awtismlover/Regin-Line-follower-v1/regin_line_follower/hardware/3d printed stuff/regin_sensor_mount v2.3mf

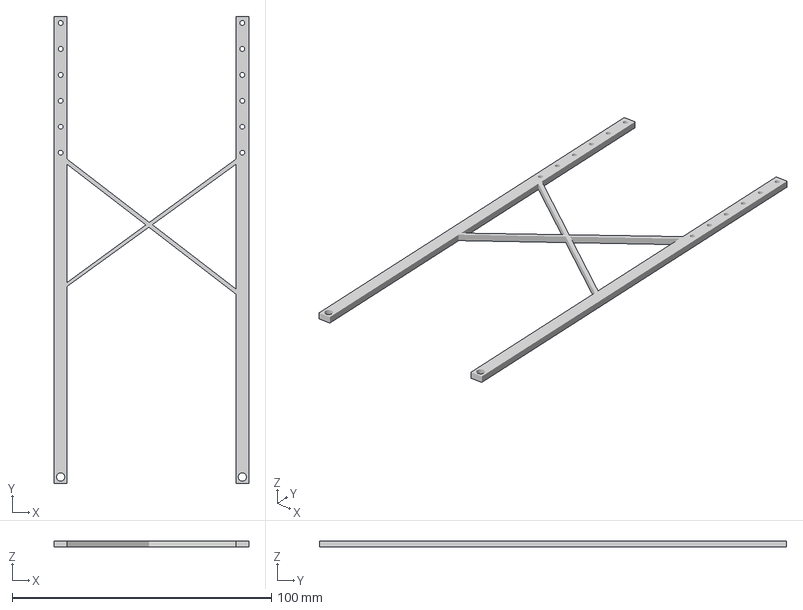
[picture p1: CAD file, 2024-11-30]
regin_line_follower/hardware/3d printed stuff/regin_sensor_mount v2.3mf
75.0 x 180.0 x 2.50 mm
