awtismlover/Regin-Line-follower-v1/regin_line_follower/hardware/PCB/3D_model/12sensor.step

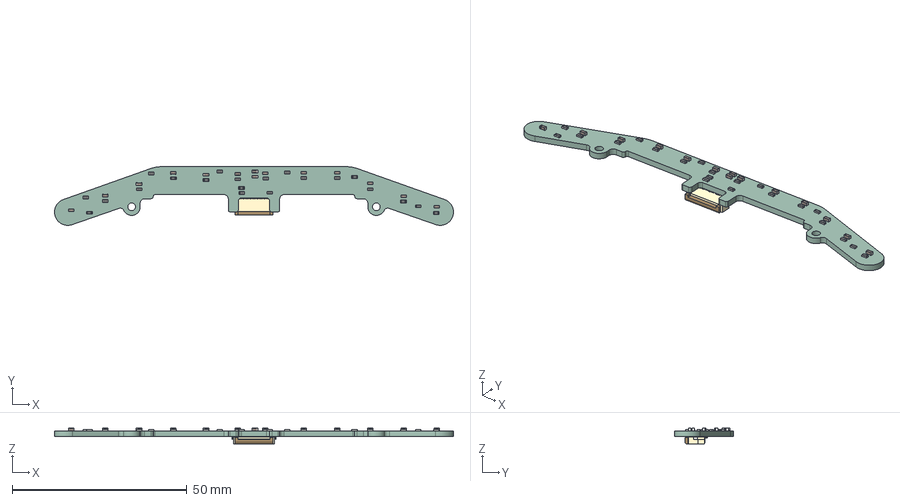
[picture p2: CAD file, 2024-11-30]
regin_line_follower/hardware/PCB/3D_model/12sensor.step
114.1 x 16.8 x 4.50 mm
C_0603_1608Metric x 14
R_0603_1608Metric x 21
Hirose_FH12_xxS_0_5SH_Parametric_v0_1
12sensor_PCB
