awtismlover/Regin-Line-follower-v1/regin_line_follower/hardware/PCB/main_board/hc-04/HC-04 v2.step

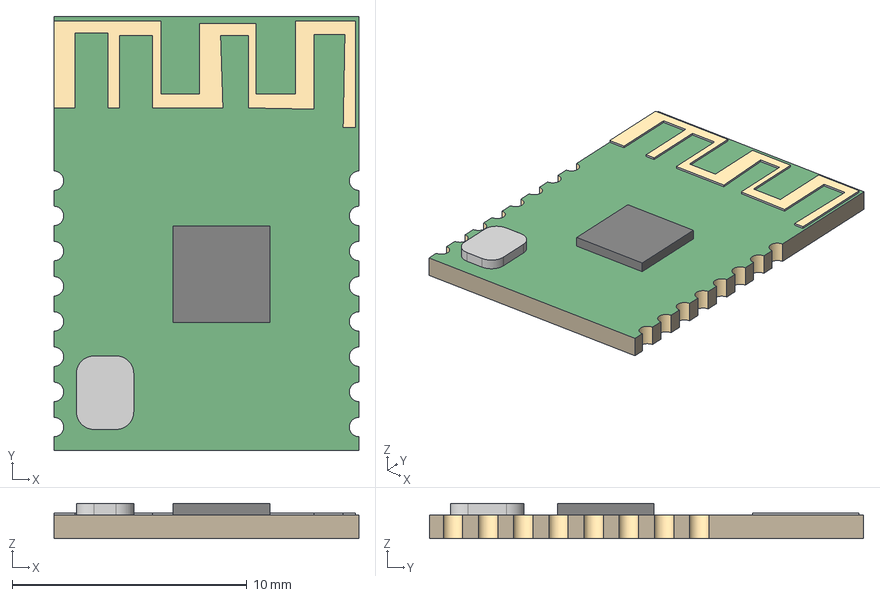
[picture p3: CAD file, 2024-11-30]
regin_line_follower/hardware/PCB/main_board/hc-04/HC-04 v2.step
13.0 x 18.5 x 1.50 mm
