awtismlover/Regin-Line-follower-v1/regin_line_follower/hardware/3d printed stuff/linefollower clip v2.3mf

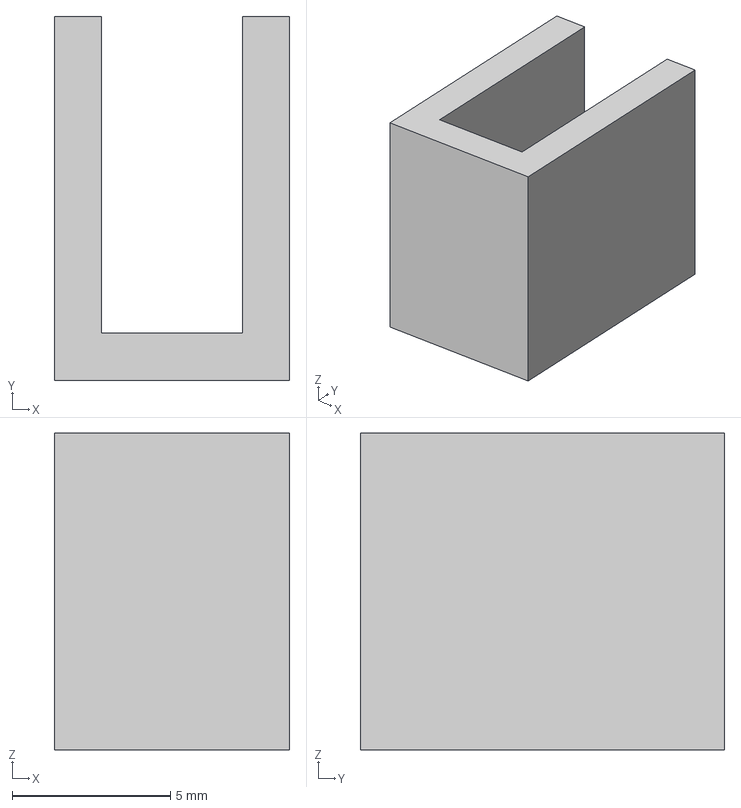
[picture p4: CAD file, 2024-11-30]
regin_line_follower/hardware/3d printed stuff/linefollower clip v2.3mf
7.44 x 11.5 x 10.0 mm
