awtismlover/Regin-Line-follower-v1/(list of files, drawings)

Other design files:
regin_line_follower/hardware/PCB/main_board/hc-04/PCB_NEW_PCB_2024-11-19.json
regin_line_follower/hardware/PCB/sensor_curved/12sensorPCB/freerouting.dsn
regin_line_follower/hardware/PCB/sensor_straight/12sensorPCB/freerouting.dsn
