awtismlover/Regin-Line-follower-v1/regin_line_follower/hardware/PCB/main_board/regin.kicad_pcb

## KiCad design regin_line_follower/hardware/PCB/main_board/regin.kicad_pcb (2024-11-30)

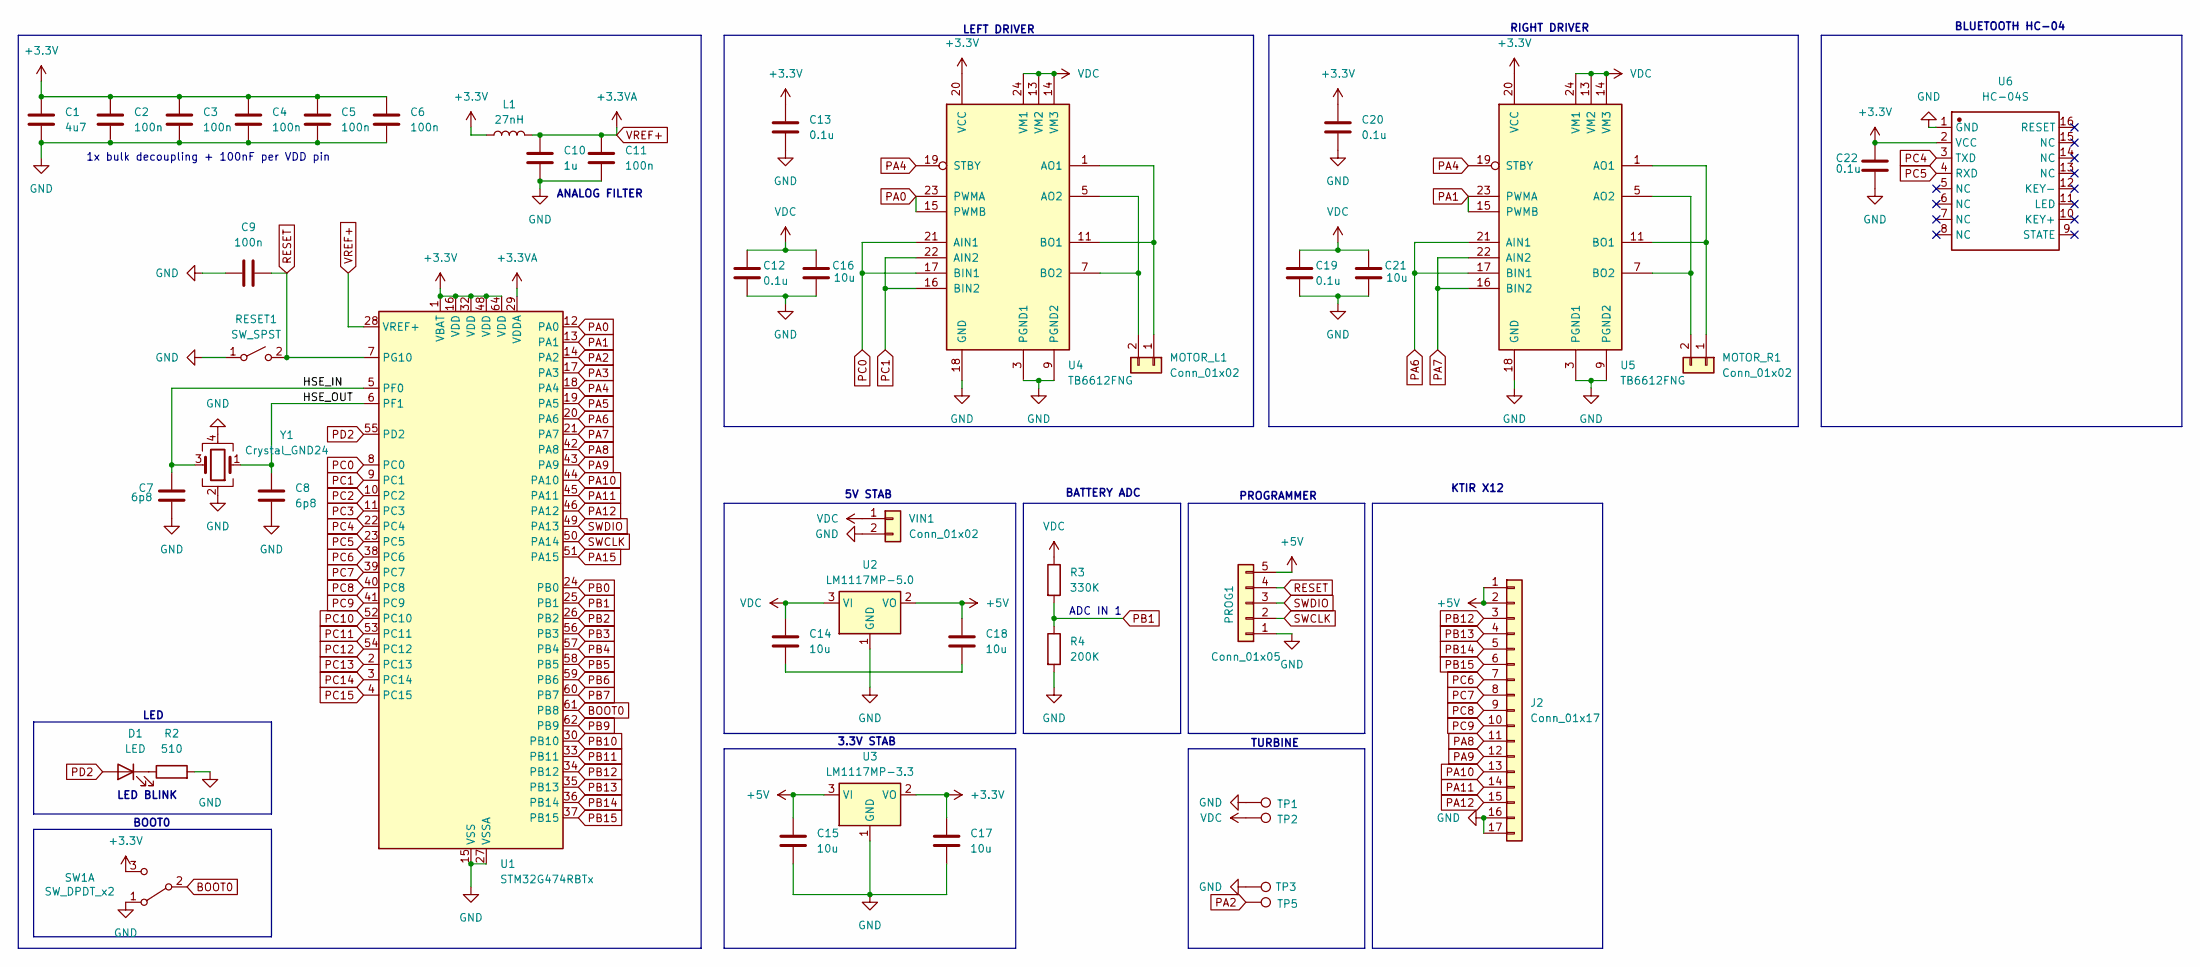
[picture p5: schematic regin.kicad_sch, Regin line follower]

Parts:
C1: 4u7; C_0603_1608Metric
C2, C3, C4, C5, C6, C9, C11: 100n; C_0603_1608Metric
C7, C8: 6p8; C_0603_1608Metric
C10: 1u; C_0603_1608Metric
C12, C13, C19, C20, C22: 0.1u; C_0603_1608Metric
C14, C15, C16, C17, C18, C21: 10u; C_0603_1608Metric
D1: LED; LED_0603_1608Metric
J2: Conn_01x17; Hirose_FH12-17S-0.5SH_1x17-1MP_P0.50mm_Horizontal
L1: 27nH; L_0603_1608Metric
MOTOR_L1: Conn_01x02; PinHeader_1x02_P2.54mm_Vertical
MOTOR_R1: Conn_01x02; PinHeader_1x02_P2.54mm_Vertical
PROG1: Conn_01x05; PinHeader_1x05_P2.54mm_Vertical
R2: 510; C_0603_1608Metric
R3: 330K; C_0603_1608Metric
R4: 200K; C_0603_1608Metric
RESET1: SW_SPST; SW_SPST_CK_RS282G05A3
SW1: SW_DPDT_x2; SW_SPDT_PCM12
TP1, TP2: TestPoint; TestPoint_Pad_D2.5mm
TP3, TP5: TestPoint; TestPoint_Pad_D1.0mm
U1: STM32G474RBTx; LQFP-64_10x10mm_P0.5mm
U2: LM1117MP-5.0; SOT-223-3_TabPin2
U3: LM1117MP-3.3; SOT-223-3_TabPin2
U4, U5: TB6612FNG; SSOP-24_5.3x8.2mm_P0.65mm
U6: HC-04S; hc-04; Manufacturer Part HC-04S
VIN1: Conn_01x02; PinSocket_1x02_P2.54mm_Vertical
Y1: Crystal_GND24; Crystal_SMD_2016-4Pin_2.0x1.6mm

Connections:
+3.3V: C1.1, C2.1, C3.1, C4.1, C5.1, C6.1, C13.1, C17.1, C20.1, C22.2, L1.1, SW1.3 (C), U1.1 (VBAT), U1.16 (VDD), U1.32 (VDD), U1.48 (VDD), U1.64 (VDD), U3.2 (VO), U4.20 (VCC), U5.20 (VCC), U6.2 (VCC)
+5V: C15.1, C18.1, J2.1, J2.2, PROG1.5, U2.2 (VO), U3.3 (VI)
/HSE_IN: C7.1, U1.5 (PF0), Y1.3
/HSE_OUT: C8.1, U1.6 (PF1), Y1.1
BOOT0: SW1.2 (B), U1.61 (PB8)
GND: C1.2, C2.2, C3.2, C4.2, C5.2, C6.2, C7.2, C8.2, C9.1, C10.2, C11.2, C12.2, C13.2, C15.2, C16.2, C17.2, C19.2, C20.2, C21.2, C22.1, J2.16, J2.17, PROG1.1, R2.2, R4.2, RESET1.1 (A), SW1.1 (A), TP1.1, TP3.1, U1.15 (VSS), U1.27 (VSSA), U1.31 (VSS), U1.47 (VSS), U1.63 (VSS), U2.1 (GND), U3.1 (GND), U4.3 (PGND1), U4.4 (PGND1), U4.9 (PGND2), U4.10 (PGND2), U4.18 (GND), U5.3 (PGND1), U5.4 (PGND1), U5.9 (PGND2), U5.10 (PGND2), U5.18 (GND), U6.1 (GND), VIN1.2, Y1.2, Y1.4; also elsewhere on the board
unnamed: C14.2, C18.2
unnamed: D1.1 (K), R2.1
unnamed: MOTOR_L1.1, U4.1 (AO1), U4.2 (AO1), U4.11 (BO1), U4.12 (BO1)
unnamed: MOTOR_L1.2, U4.5 (AO2), U4.6 (AO2), U4.7 (BO2), U4.8 (BO2)
unnamed: MOTOR_R1.1, U5.1 (AO1), U5.2 (AO1), U5.11 (BO1), U5.12 (BO1)
unnamed: MOTOR_R1.2, U5.5 (AO2), U5.6 (AO2), U5.7 (BO2), U5.8 (BO2)
PA0: U1.12 (PA0), U4.15 (PWMB), U4.23 (PWMA)
PA1: U1.13 (PA1), U5.15 (PWMB), U5.23 (PWMA)
PA2: TP5.1, U1.14 (PA2); also elsewhere on the board
PA3: U1.17 (PA3)
PA4: U1.18 (PA4), U4.19 (STBY), U5.19 (STBY)
PA5: U1.19 (PA5)
PA6: U1.20 (PA6), U5.17 (BIN1), U5.21 (AIN1)
PA7: U1.21 (PA7), U5.16 (BIN2), U5.22 (AIN2)
PA8: J2.11, U1.42 (PA8)
PA9: J2.12, U1.43 (PA9)
PA10: J2.13, U1.44 (PA10)
PA11: J2.14, U1.45 (PA11)
PA12: J2.15, U1.46 (PA12)
PA15: U1.51 (PA15)
PB0: U1.24 (PB0)
PB1: R3.2, R4.1, U1.25 (PB1)
PB2: U1.26 (PB2)
PB3: U1.56 (PB3)
PB4: U1.57 (PB4)
PB5: U1.58 (PB5)
PB6: U1.59 (PB6)
PB7: U1.60 (PB7)
PB9: U1.62 (PB9)
PB10: U1.30 (PB10)
PB11: U1.33 (PB11)
PB12: J2.3, U1.34 (PB12)
PB13: J2.4, U1.35 (PB13)
PB14: J2.5, U1.36 (PB14)
PB15: J2.6, U1.37 (PB15)
PC0: U1.8 (PC0), U4.17 (BIN1), U4.21 (AIN1)
PC1: U1.9 (PC1), U4.16 (BIN2), U4.22 (AIN2)
PC2: U1.10 (PC2)
PC3: U1.11 (PC3)
PC4: U1.22 (PC4), U6.3 (TXD)
PC5: U1.23 (PC5), U6.4 (RXD)
PC6: J2.7, U1.38 (PC6)
PC7: J2.8, U1.39 (PC7)
PC8: J2.9, U1.40 (PC8)
PC9: J2.10, U1.41 (PC9)
PC10: U1.52 (PC10)
PC11: U1.53 (PC11)
PC12: U1.54 (PC12)
PC13: U1.2 (PC13)
PC14: U1.3 (PC14)
PC15: U1.4 (PC15)
PD2: D1.2 (A), U1.55 (PD2)
RESET: C9.2, PROG1.4, RESET1.2 (B), U1.7 (PG10)
SWCLK: PROG1.2, U1.50 (PA14)
SWDIO: PROG1.3, U1.49 (PA13)
VDC: C12.1, C14.1, C16.1, C19.1, C21.1, R3.1, TP2.1, U2.3 (VI), U4.13 (VM2), U4.14 (VM3), U4.24 (VM1), U5.13 (VM2), U5.14 (VM3), U5.24 (VM1), VIN1.1; also elsewhere on the board
VREF+: C10.1, C11.1, L1.2, U1.28 (VREF+), U1.29 (VDDA)

Notes on the sheet:
ADC IN 1
ANALOG FILTER
TURBINE
1x bulk decoupling + 100nF per VDD pin
RIGHT DRIVER
3.3V STAB
LED
BATTERY ADC
5V STAB
BLUETOOTH HC-04
PROGRAMMER
KTIR X12
BOOT0
LEFT DRIVER
LED BLINK

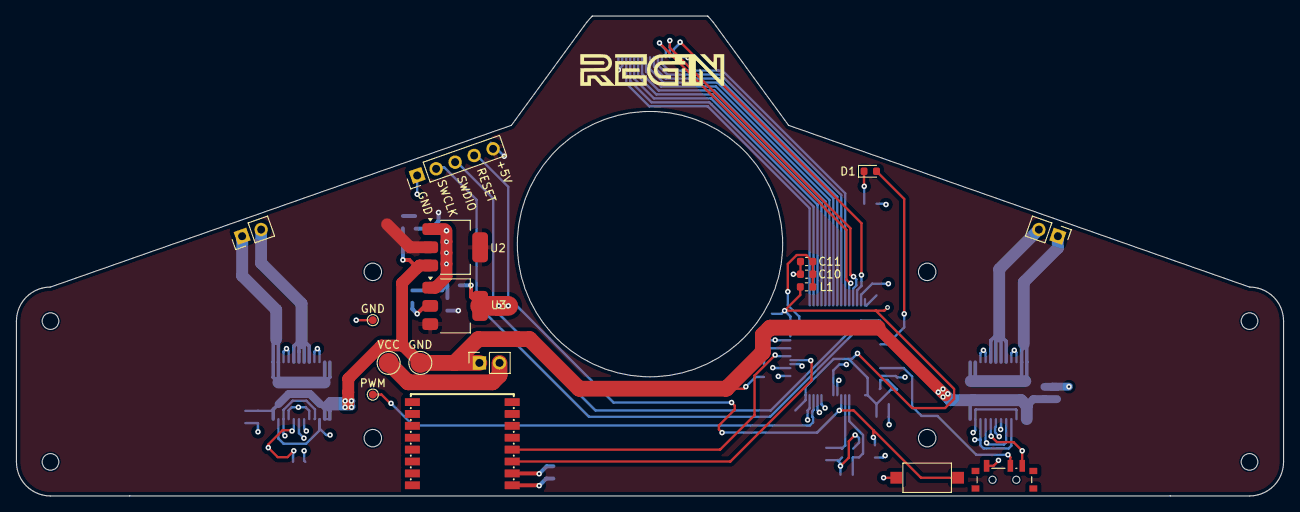
[picture p6: board regin.kicad_pcb from above]

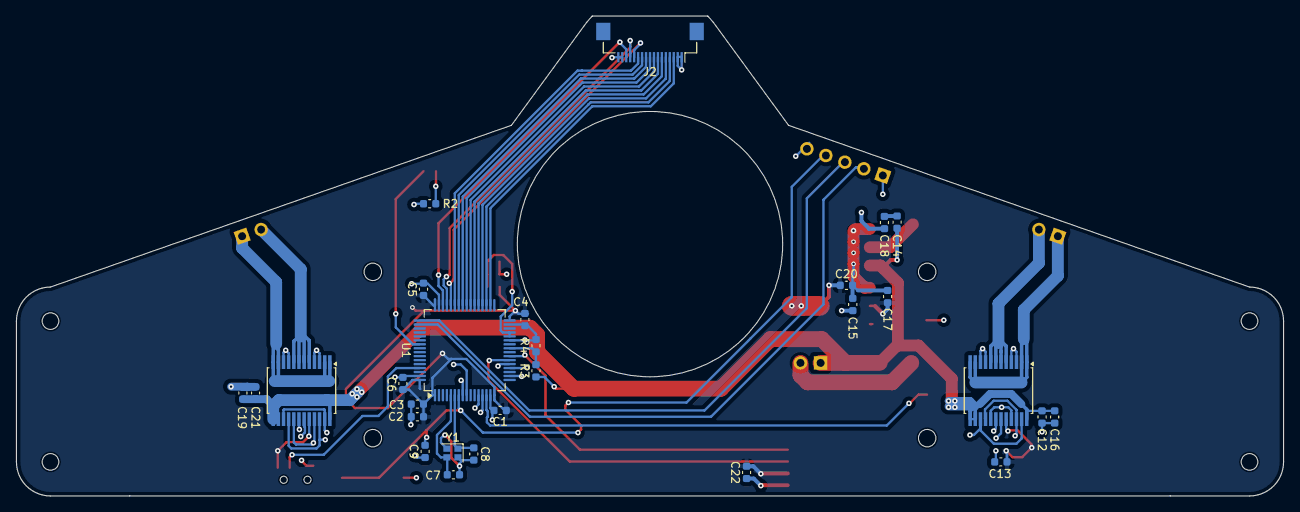
[picture p7: board regin.kicad_pcb from below]

Board: 4 copper layers, 160.0 x 60.6 mm, 49 parts (28 on the bottom side), 42 nets.

Other parts of the board:
GND: TestPoint; TestPoint_Pad_D2.5mm
GND#2: TestPoint; TestPoint_Pad_D1.0mm
H1, H2, H3, H4: MountingHole; MountingHole_2.2mm_M2
PWM: TestPoint; TestPoint_Pad_D1.0mm
VCC: TestPoint; TestPoint_Pad_D2.5mm

Their connections:
GND: GND#2.1, VCC.1; also elsewhere on the board
PA2: PWM.1; also elsewhere on the board
VDC: GND.1; also elsewhere on the board
