awtismlover/Regin-Line-follower-v1/regin_line_follower/hardware/PCB/sensor_straight/12sensorPCB/12sensor.kicad_pcb

## KiCad design regin_line_follower/hardware/PCB/sensor_straight/12sensorPCB/12sensor.kicad_pcb (2024-11-30)

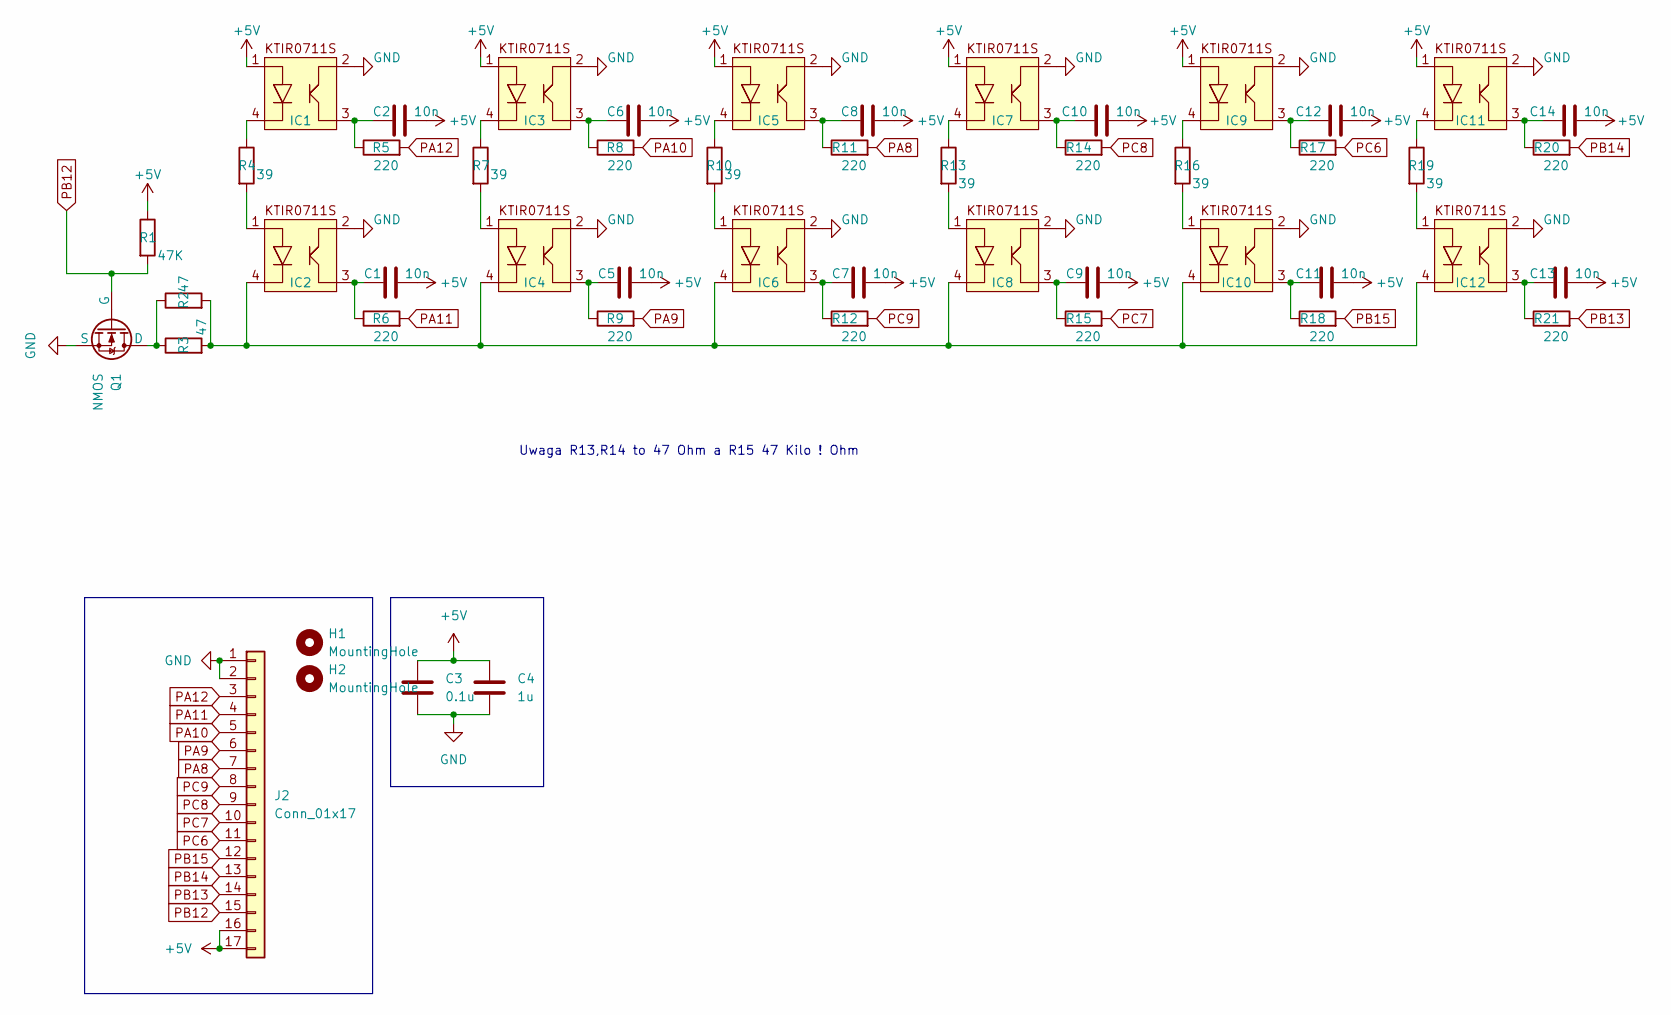
[picture p8: schematic 12sensor.kicad_sch]

Parts:
C1, C2, C5, C6, C7, C8, C9, C10, C11, C12, C13, C14: 10n; C_0603_1608Metric
C3: 0.1u; C_0603_1608Metric
C4: 1u; C_0603_1608Metric
H1, H2: MountingHole; MountingHole_2.2mm_M2
IC1, IC2, IC3, IC4, IC5, IC6, IC7, IC8, IC9, IC10, IC11, IC12: KTIR0711S
J2: Conn_01x17; Hirose_FH12-17S-0.5SH_1x17-1MP_P0.50mm_Horizontal
Q1: NMOS; NMOS_SN
R1: 47K; R_0603_1608Metric
R2, R3: 47; R_0603_1608Metric
R4, R7, R10, R13, R16, R19: 39; R_0603_1608Metric
R5, R6, R8, R9, R11, R12, R14, R15, R17, R18, R20, R21: 220; R_0603_1608Metric

Connections:
+5V: C1.2, C2.2, C3.1, C4.1, C5.2, C6.2, C7.2, C8.2, C9.2, C10.2, C11.2, C12.2, C13.2, C14.2, IC1.1, IC3.1, IC5.1, IC7.1, IC9.1, IC11.1, J2.16, J2.17, R1.1; also elsewhere on the board
GND: C3.2, C4.2, IC1.2, IC2.2, IC3.2, IC4.2, IC5.2, IC6.2, IC7.2, IC8.2, IC9.2, IC10.2, IC11.2, IC12.2, J2.1, J2.2, Q1.3 (S); also elsewhere on the board
unnamed: C1.1, IC2.3, R6.1
unnamed: C2.1, IC1.3, R5.1
unnamed: C5.1, IC4.3, R9.1
unnamed: C6.1, IC3.3, R8.1
unnamed: C7.1, IC6.3, R12.1
unnamed: C8.1, IC5.3, R11.1
unnamed: C9.1, IC8.3, R15.1
unnamed: C10.1, IC7.3, R14.1
unnamed: C11.1, IC10.3, R18.1
unnamed: C12.1, IC9.3, R17.1
unnamed: C13.1, IC12.3, R21.1
unnamed: C14.1, IC11.3, R20.1
unnamed: IC1.4, R4.1
unnamed: IC2.1, R4.2
unnamed: IC3.4, R7.1
unnamed: IC4.1, R7.2
unnamed: IC5.4, R10.1
unnamed: IC6.1, R10.2
unnamed: IC7.4, R13.1
unnamed: IC8.1, R13.2
unnamed: IC9.4, R16.1
unnamed: IC10.1, R16.2
unnamed: IC2.4, IC4.4, IC6.4, IC8.4, IC10.4, IC12.4, R2.2, R3.2
unnamed: IC11.4, R19.1
unnamed: IC12.1, R19.2
unnamed: Q1.1 (D), R2.1, R3.1
PA8: J2.7, R11.2; also elsewhere on the board
PA9: J2.6, R9.2; also elsewhere on the board
PA10: J2.5, R8.2; also elsewhere on the board
PA11: J2.4, R6.2; also elsewhere on the board
PA12: J2.3, R5.2; also elsewhere on the board
PB12: J2.15, Q1.2 (G), R1.2; also elsewhere on the board
PB13: J2.14, R21.2; also elsewhere on the board
PB14: J2.13, R20.2; also elsewhere on the board
PB15: J2.12, R18.2; also elsewhere on the board
PC6: J2.11, R17.2; also elsewhere on the board
PC7: J2.10, R15.2; also elsewhere on the board
PC8: J2.9, R14.2; also elsewhere on the board
PC9: J2.8, R12.2; also elsewhere on the board

Notes on the sheet:
Uwaga R13,R14 to 47 Ohm a R15 47 Kilo ! Ohm

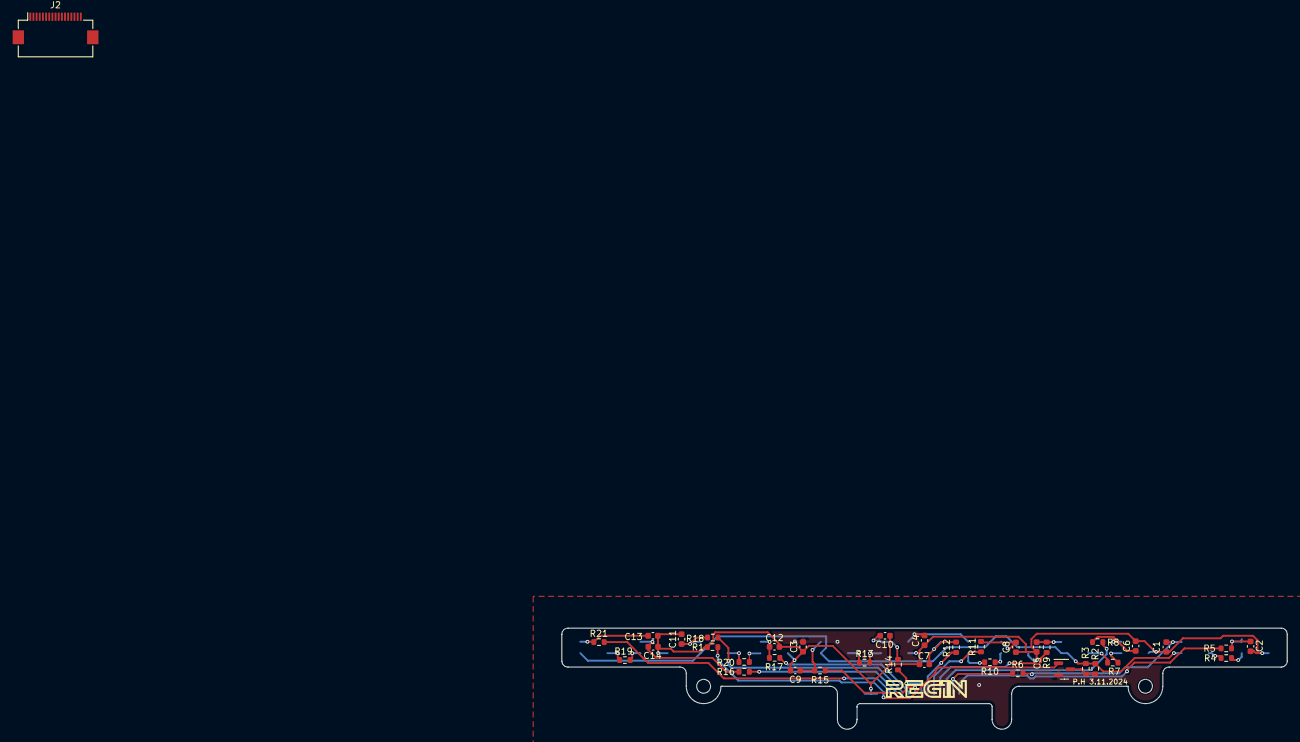
[picture p9: board 12sensor.kicad_pcb from above]

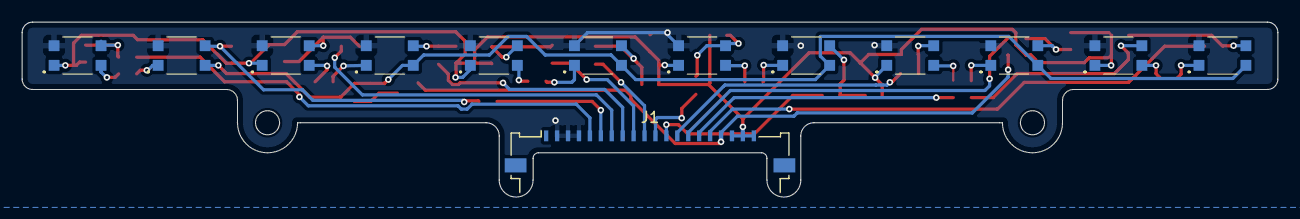
[picture p10: board 12sensor.kicad_pcb from below]

Board: 2 copper layers, 114.9 x 16.0 mm, 52 parts (13 on the bottom side), 41 nets.

Other parts of the board:
J1: Conn_01x20; Molex_200528-0200_1x20-1MP_P1.00mm_Horizontal

Their connections:
+5V: J1.18, J1.19, J1.20; also elsewhere on the board
GND: J1.2, J1.3, J1.4; also elsewhere on the board
PA8: J1.9; also elsewhere on the board
PA9: J1.8; also elsewhere on the board
PA10: J1.7; also elsewhere on the board
PA11: J1.6; also elsewhere on the board
PA12: J1.5; also elsewhere on the board
PB12: J1.17; also elsewhere on the board
PB13: J1.16; also elsewhere on the board
PB14: J1.15; also elsewhere on the board
PB15: J1.14; also elsewhere on the board
PC6: J1.13; also elsewhere on the board
PC7: J1.12; also elsewhere on the board
PC8: J1.11; also elsewhere on the board
PC9: J1.10; also elsewhere on the board
