awtismlover/Regin-Line-follower-v1/(notices)

Notices in the files:
regin_line_follower/software/cubeide/autismv0.1/Core/Inc/main.h:
Copyright (c) 2024 STMicroelectronics.
All rights reserved.
This software is licensed under terms that can be found in the LICENSE file
